Rob382/salidas-programables-mejora-de-auto-alarma-/README.md

# Salidas-programables-mejora-de-auto-alarma-
En este proyecto yo hice el rediseño (electrónico y programas), así como modificaciones del sistema de auto alarma previamente implementado por la empresa, solucionando los problemas de consumo de energía y mejorando el circuito funcional (la parte automática) con un rediseño total.

El rediseño se concentró principalmente en crear un sistema de salidas programables el cual con una o dos salidas (a elección) del panel de alarma pueda controlar 4 salidas dobles que pueden programarse para actuar de la manera en que se desea.

Al usar solo dos salidas se fácilita la tarea de utilizar un pánel de alarma mas pequeño reduciendo así la inversión necesaria para el desarrollo del proyecto y las dimenciones del producto final además de darle una estética más profesional.

Accesoriamente se rediseñó toda la configuración de sensores previos para así subsanar los errores de diseño previos que causaban que la enería se drenara (la batería del automóvil).

Para poder configurarlo y programarlo se requiere de un programador el cual también se diseñó especialmente pensando para realizar esta tarea.

Se entregan los arvhicos de programación y esquemáticos así como un manual detallado de uso y configuración y un reporte del estádo actual del proyecto.
