Rob382/salidas-programables-mejora-de-auto-alarma-/4- adjuntos programador attiny/esquematicos/programador ATtiny esquematico.pdf

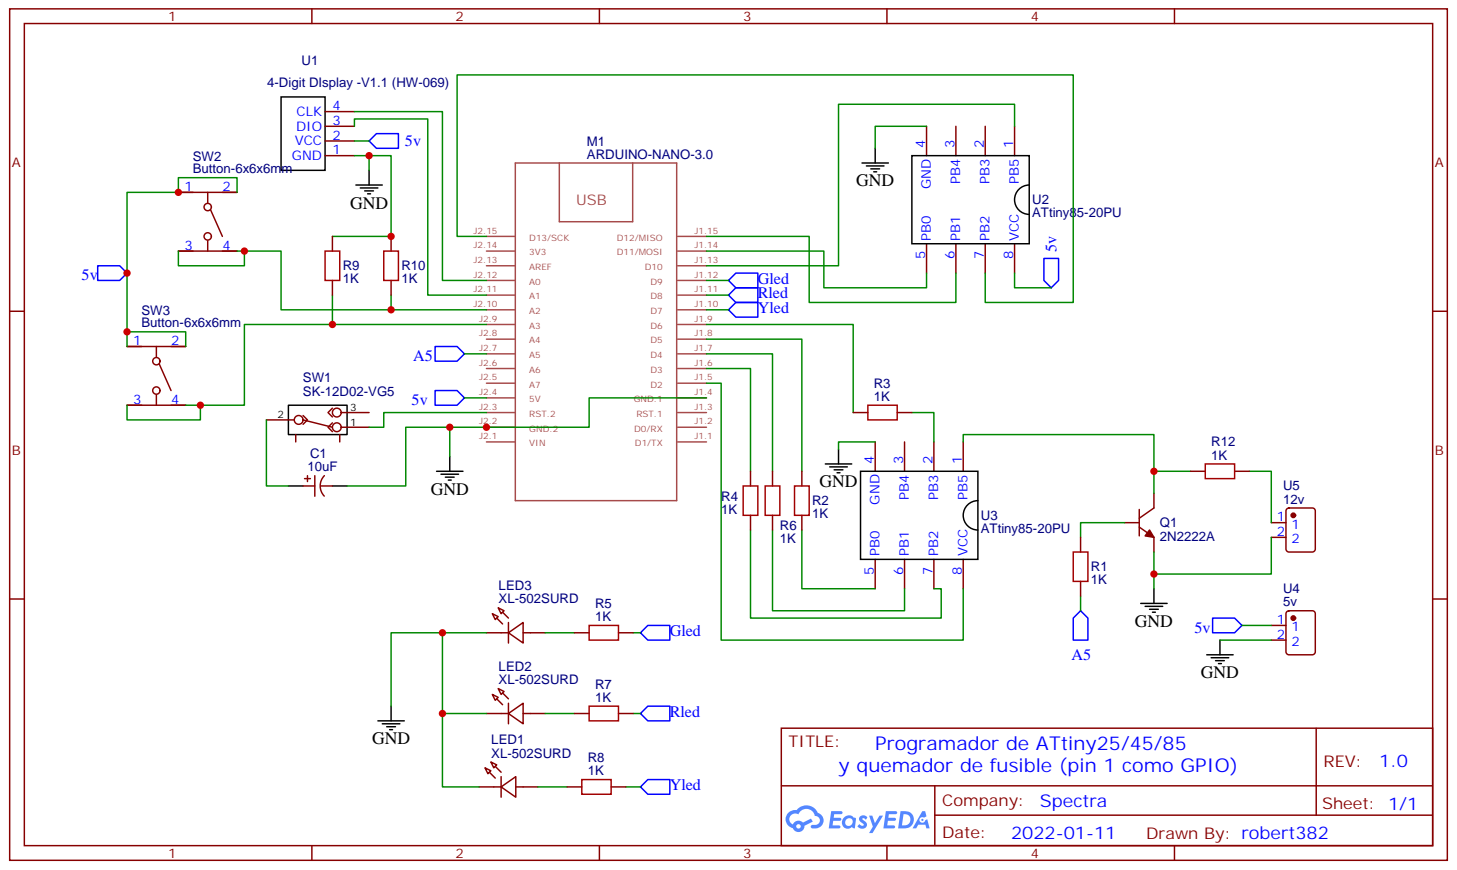
[picture p8: page 1]

y quemador de fusible (pin 1 como GPIO)
