Rob382/salidas-programables-mejora-de-auto-alarma-/5- Instalación panel CNord (WRL) beat 2019 10-01-2022.pdf

# CNrod WRL

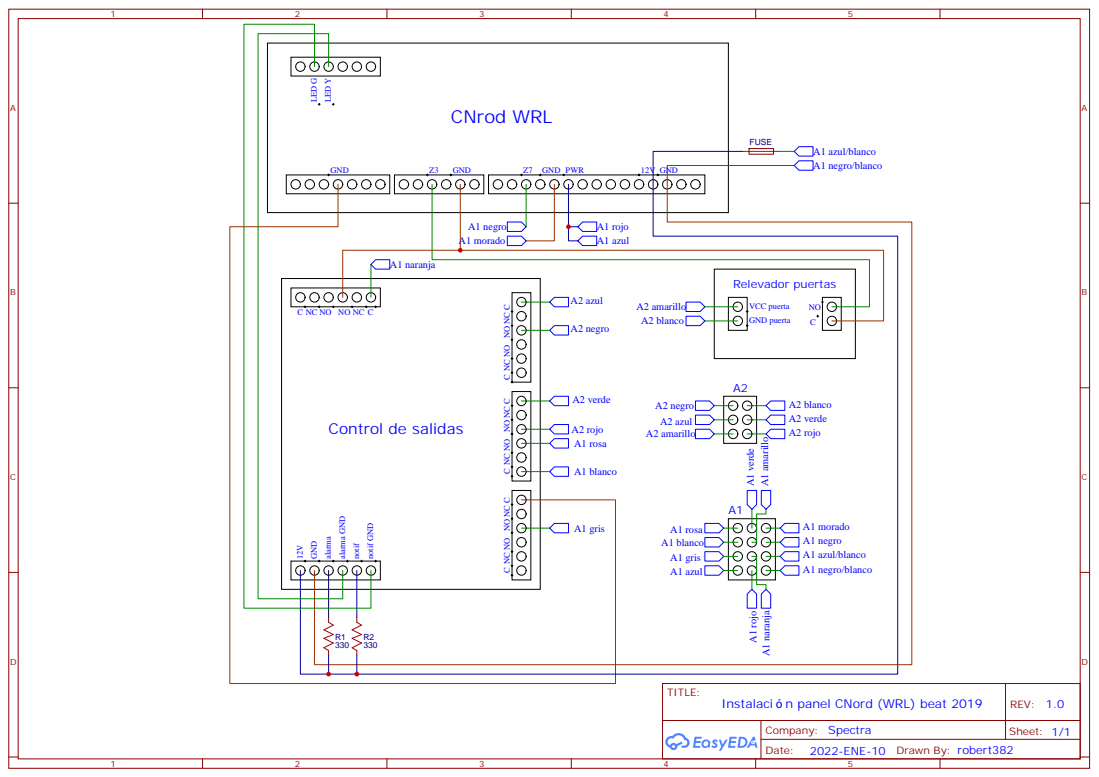
[picture p9: page 1]
