Rob382/salidas-programables-mejora-de-auto-alarma-/3- Adjuntos control de salidas programables/esquematicos/salidas programablesscheme.pdf

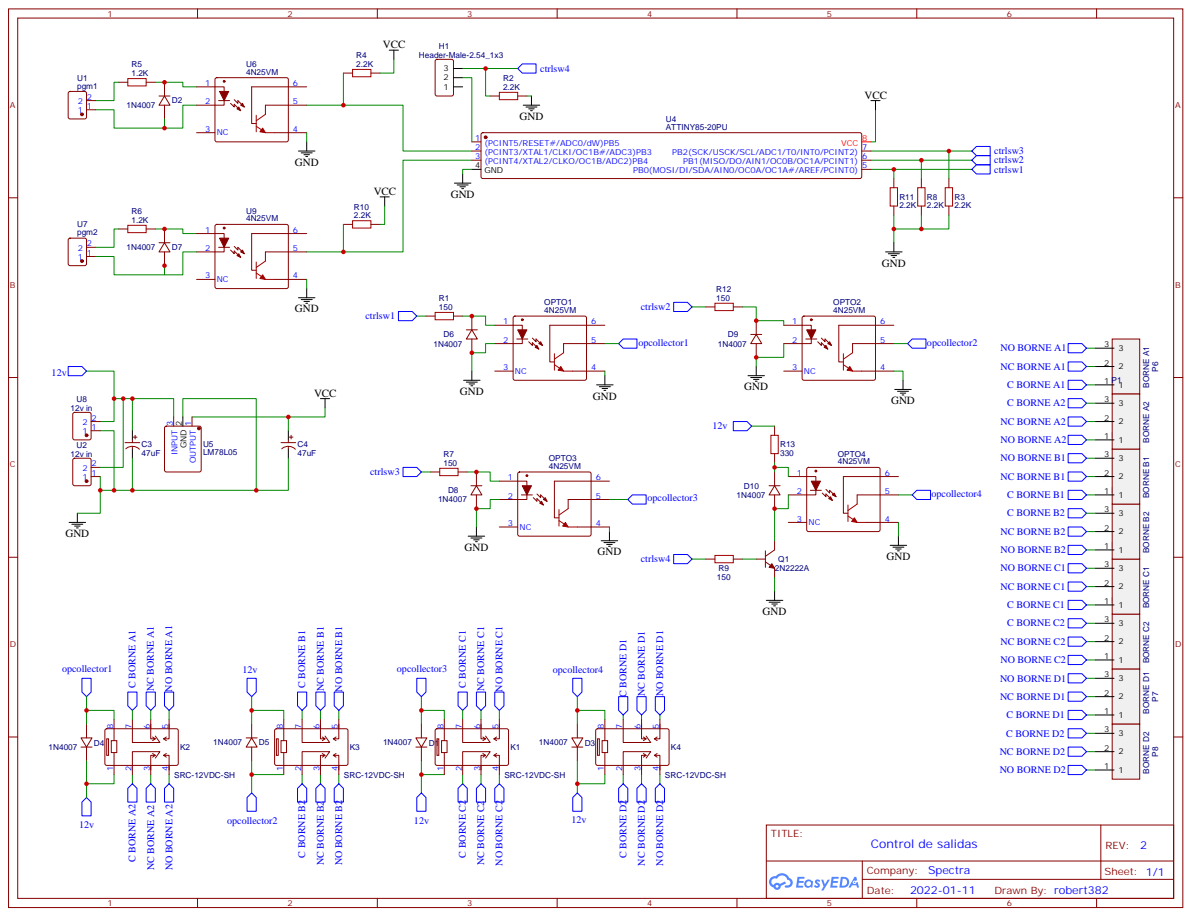
[picture p10: page 1]

PB0(MOSI/DI/SDA/AIN0/OC0A/OC1A#/AREF/PCINT0) 5
