Rob382/salidas-programables-mejora-de-auto-alarma-/3- Adjuntos control de salidas programables/PCB/control salidas programables capa inferior.pdf

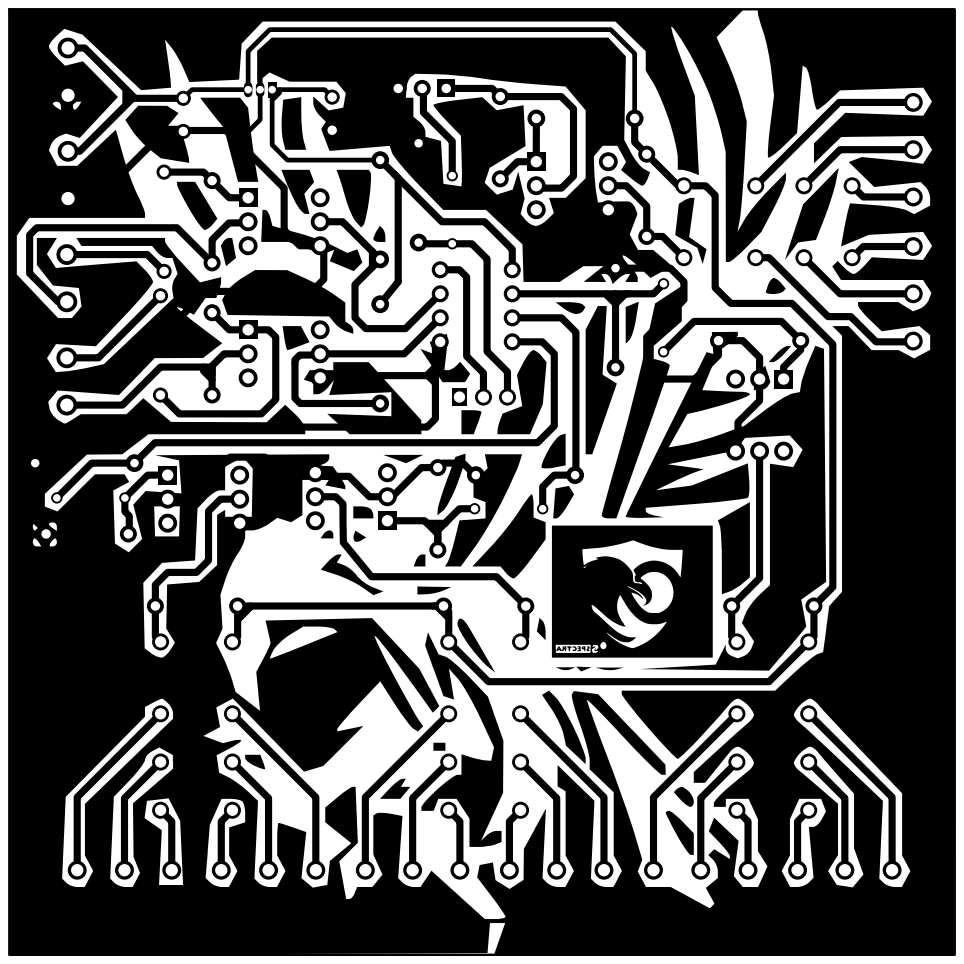
[picture p12: page 1]
