Rob382/salidas-programables-mejora-de-auto-alarma-/3- Adjuntos control de salidas programables/PCB/control salidas programables capa superior espejo.pdf

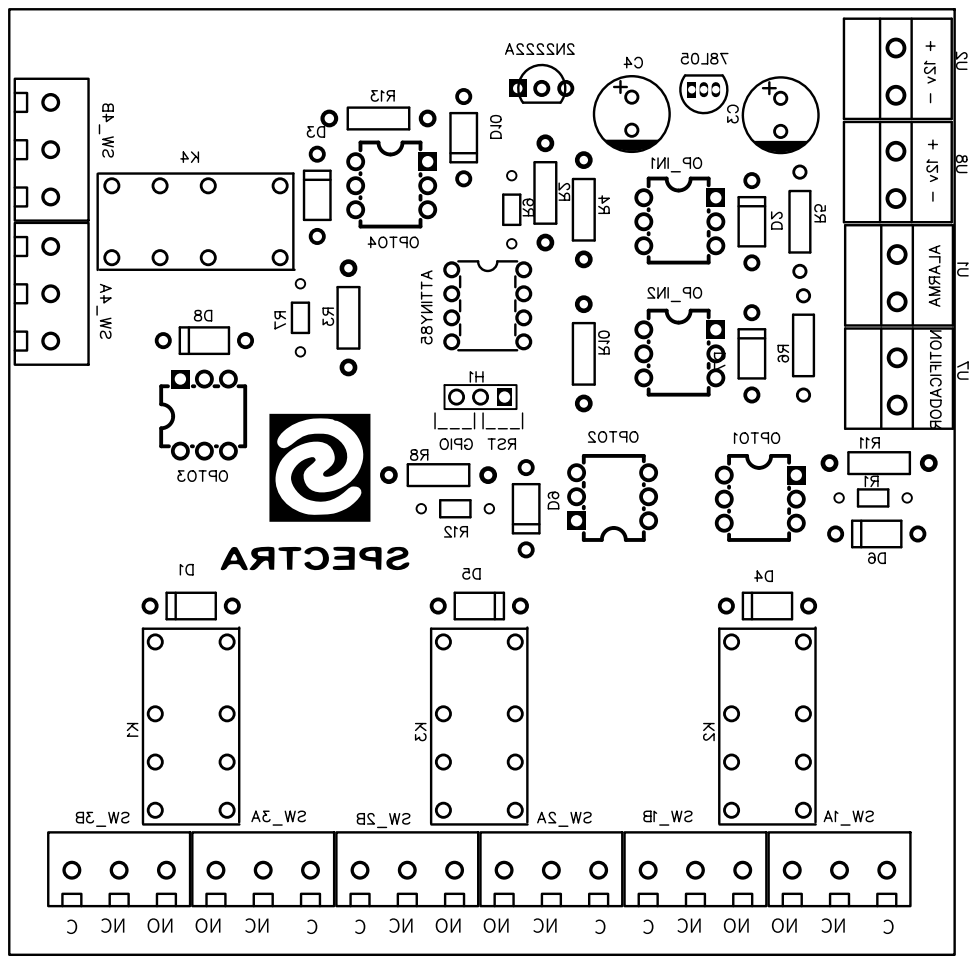
[picture p13: page 1]
