Rob382/salidas-programables-mejora-de-auto-alarma-/3- Adjuntos control de salidas programables/PCB/control salidas programables capa superor.pdf

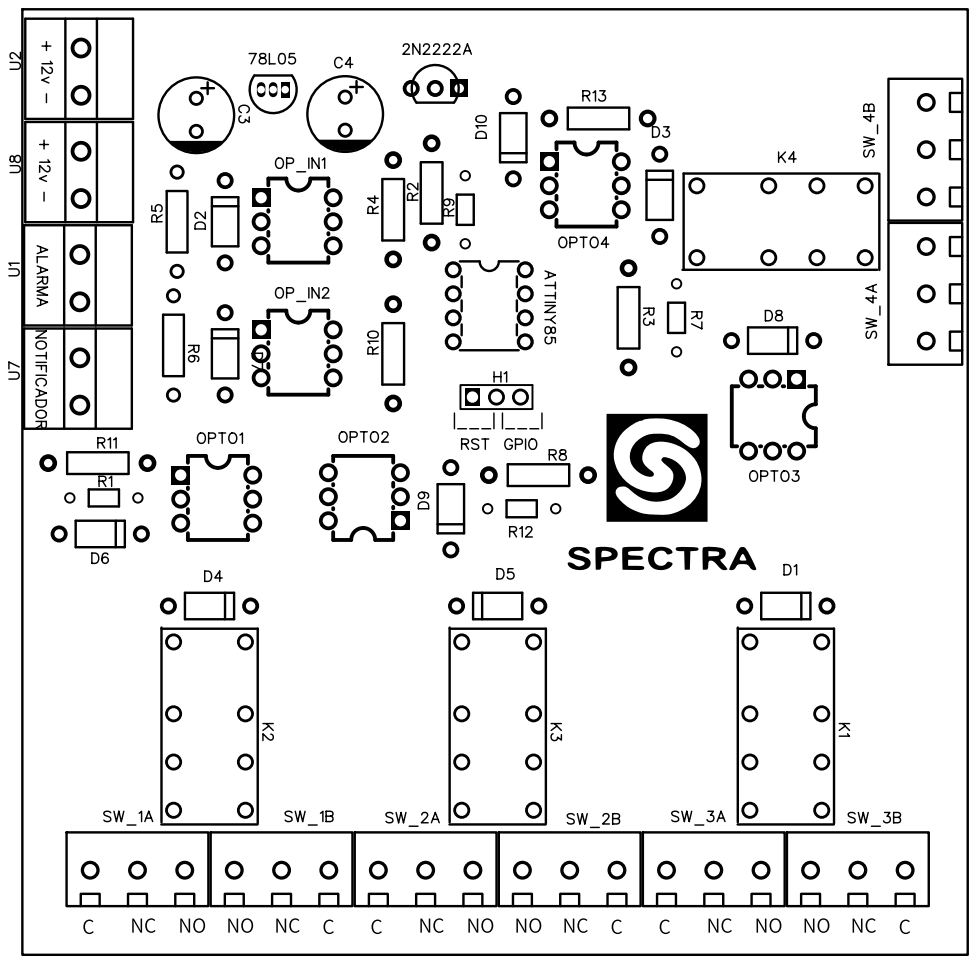
[picture p14: page 1]
