Rob382/salidas-programables-mejora-de-auto-alarma-/4- adjuntos programador attiny/PCB/programador inferior espejo.pdf

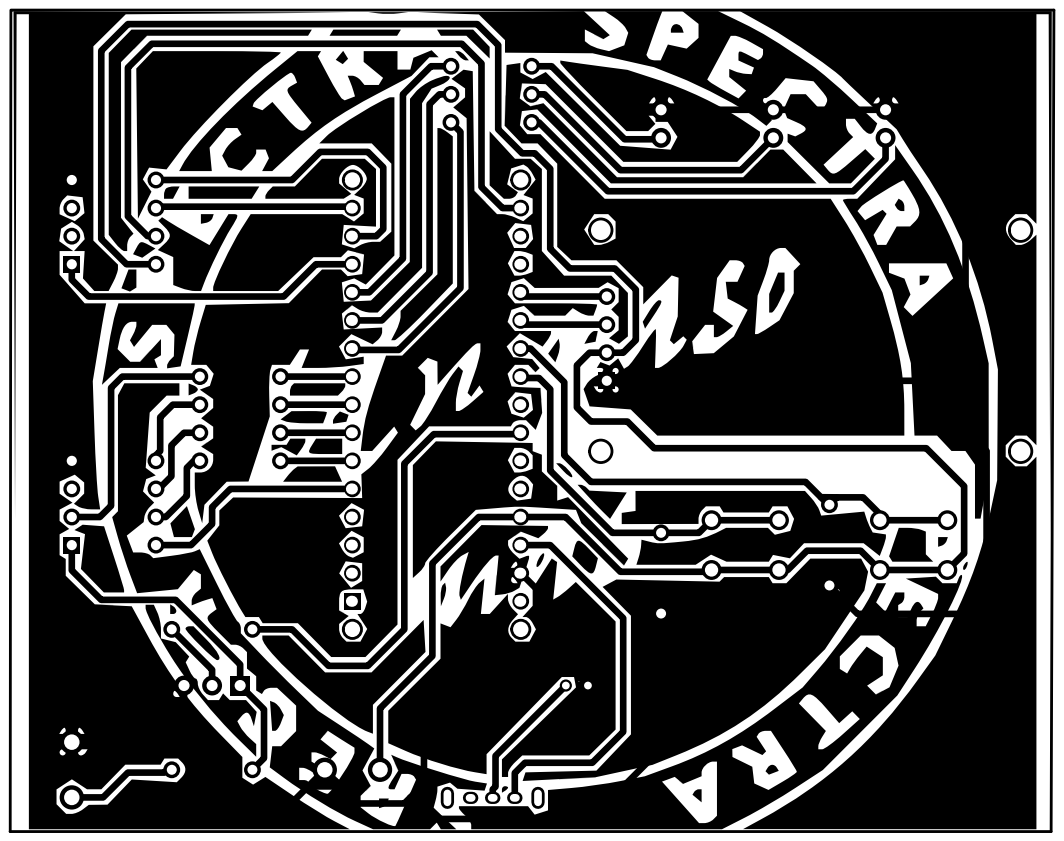
[picture p15: page 1]
