Rob382/salidas-programables-mejora-de-auto-alarma-/4- adjuntos programador attiny/PCB/programador inferior.pdf

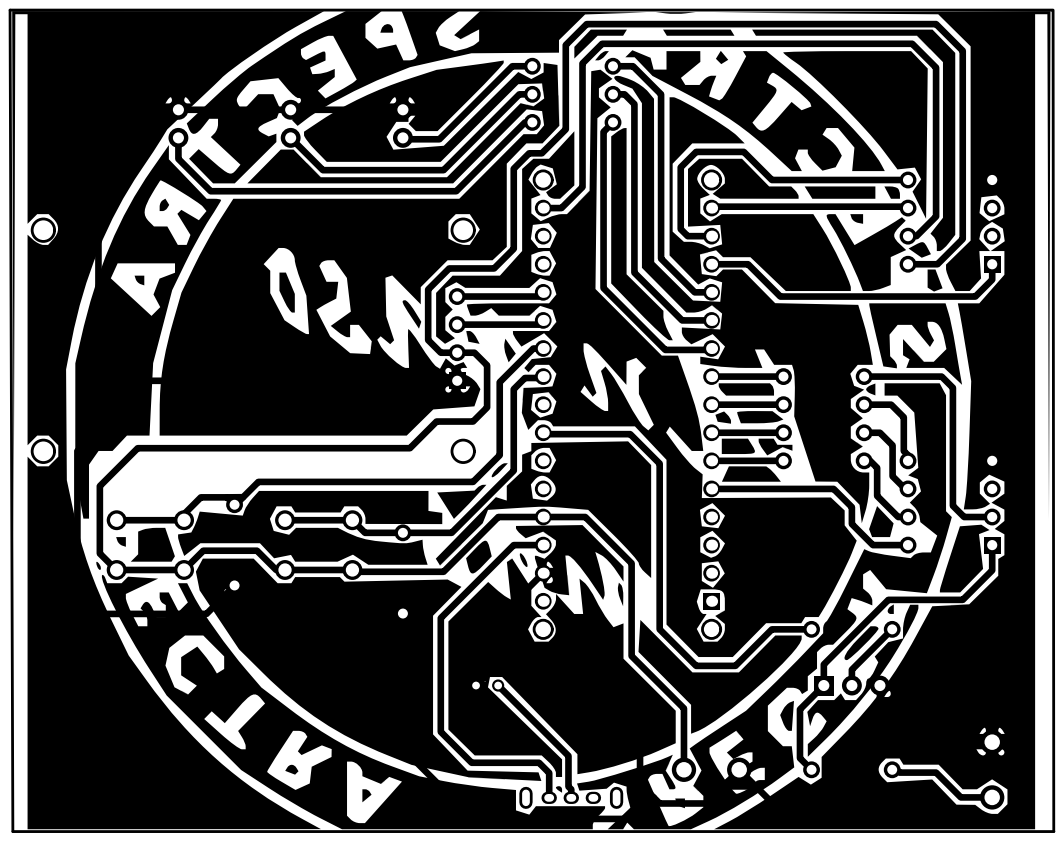
[picture p16: page 1]
