Rob382/salidas-programables-mejora-de-auto-alarma-/4- adjuntos programador attiny/PCB/programador superior espejo.pdf

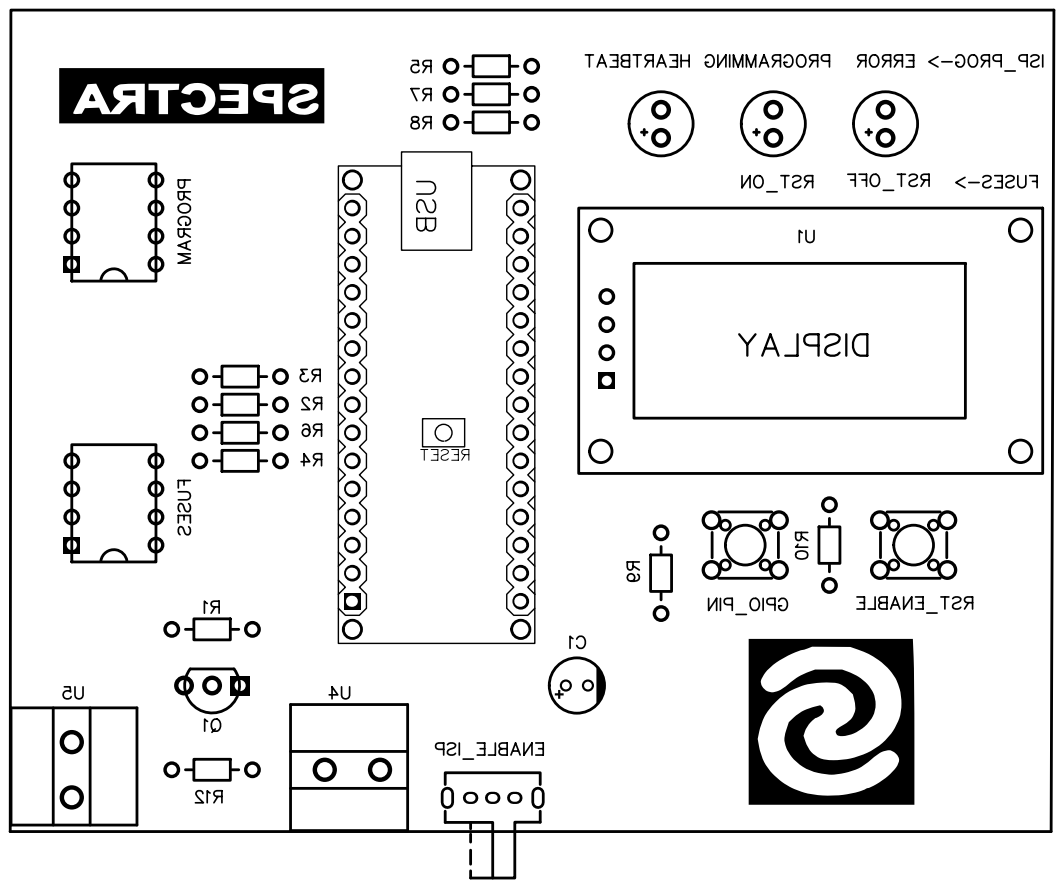
[picture p17: page 1]
