Rob382/salidas-programables-mejora-de-auto-alarma-/4- adjuntos programador attiny/PCB/programador superior.pdf

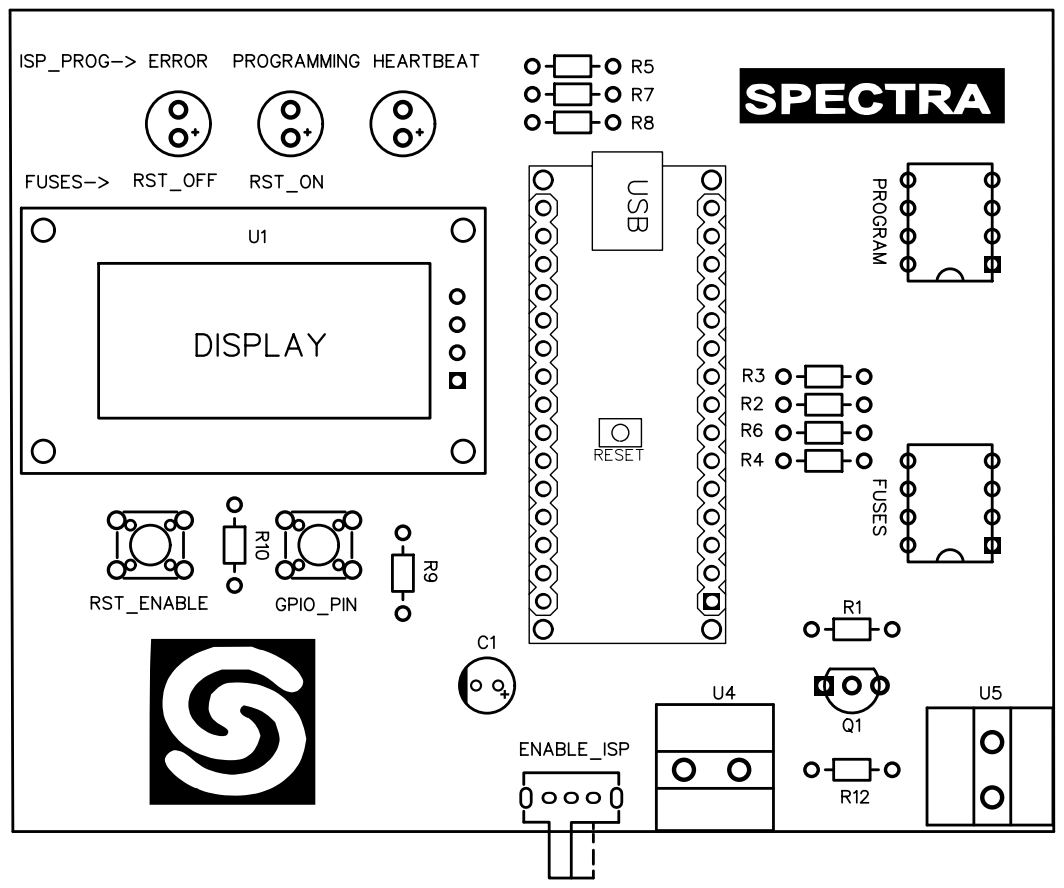
[picture p18: page 1]
