Rob382/salidas-programables-mejora-de-auto-alarma-/(list of files, drawings)

Other design files:
3- Adjuntos control de salidas programables/PCB/PCB_control salidas programables.json
4- adjuntos programador attiny/esquematicos/programador ATtiny easyeda.json
4- adjuntos programador attiny/PCB/PCB_programador ATtiny .json
