Rob382/salidas-programables-mejora-de-auto-alarma-/2- Programas arduino/Salidas_programables_ATtiny/leer_2_entradas.ino

void leer_2_entradas(){
byte entrada1 = digitalRead(3);
byte entrada2 = digitalRead(4);

// se le da prioridad a la entrada 1 (salida de sirena CNord), si hay alarma ignora el estado de la entrada 2
//(usan lógica inversa LOW es activo HIGH es desavtivado)
if ((entrada1 == LOW) && ((currentMillis - ultimaentrada1) >= 100) && (alarma == false)){
  alarma = true;
  armado = false;
  desarmado = false;
  ultimaentrada1 = currentMillis;
}

//si no hay alarma se lee la entrada 2 (salida notificador CNord)para detectar si está armado o desarmado
//(usa lógica iversa LOW es activo y HIGH es desactivado)
if (entrada1 == HIGH){
digitalWrite(2, LOW);               //apaga la sirena (claxón)
//digitalWrite(5, LOW);             //apaga la bocina
  
if ((entrada2 == LOW) && ((currentMillis - ultimaentrada2) >= 100) && (armado == false)){
  armado = true;
  desarmado = false;
  alarma = false;
  tonoactivado = false;
  contadortono = 0;
  ultimaentrada2 = currentMillis;
}
else if((entrada2 == HIGH) && ((currentMillis - ultimaentrada2) >= 100) && (desarmado ==false)){
  armado = false;
  desarmado = true;
  alarma = false;
  tonoactivado = false;
  contadortono = 0;
  ultimaentrada2 = currentMillis;
}
}
}
